rafaelmartins/julialabs-pcb-challenge2025/README.md

# julialabs-pcb-challenge2025

Meu projeto do Julialabs PCB Challenge 2025.

Placa de circuito impresso baseada no formato de um cartão de visitas tradicional, implementando um sintetizador digital polifônico completo, com mini teclado e alto falante embutidos e saída de audio em linha para gravações.

> [!NOTE]
> **Recursos Externos**
>
> - [Apresentação](https://rafaelmartins.com/s/julialabs-pcb-challenge-2025/)
> - [Lista de Componentes na Mouser](https://www.mouser.de/api/CrossDomain/GetContext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)

## Revisão `20250818`

- [Lista Interativa de Materiais](https://rafaelmartins.github.io/julialabs-pcb-challenge2025/business-card-synth.html)
- [Diagrama Esquemático](https://rafaelmartins.github.io/julialabs-pcb-challenge2025/business-card-synth.pdf)
- [Arquivos Gerber](https://github.com/rafaelmartins/julialabs-pcb-challenge2025/blob/main/pcb/gerber/business-card-synth_rev20250818.zip)

Renderização 3D

## Licença

O projeto de hardware esta disponível a partir de uma [Licença CERN-OHL-S-2.0](LICENSE).
