rafaelmartins/julialabs-pcb-challenge2025/pcb/business-card-synth.kicad_pcb

## KiCad design pcb/business-card-synth.kicad_pcb (2025-08-19)

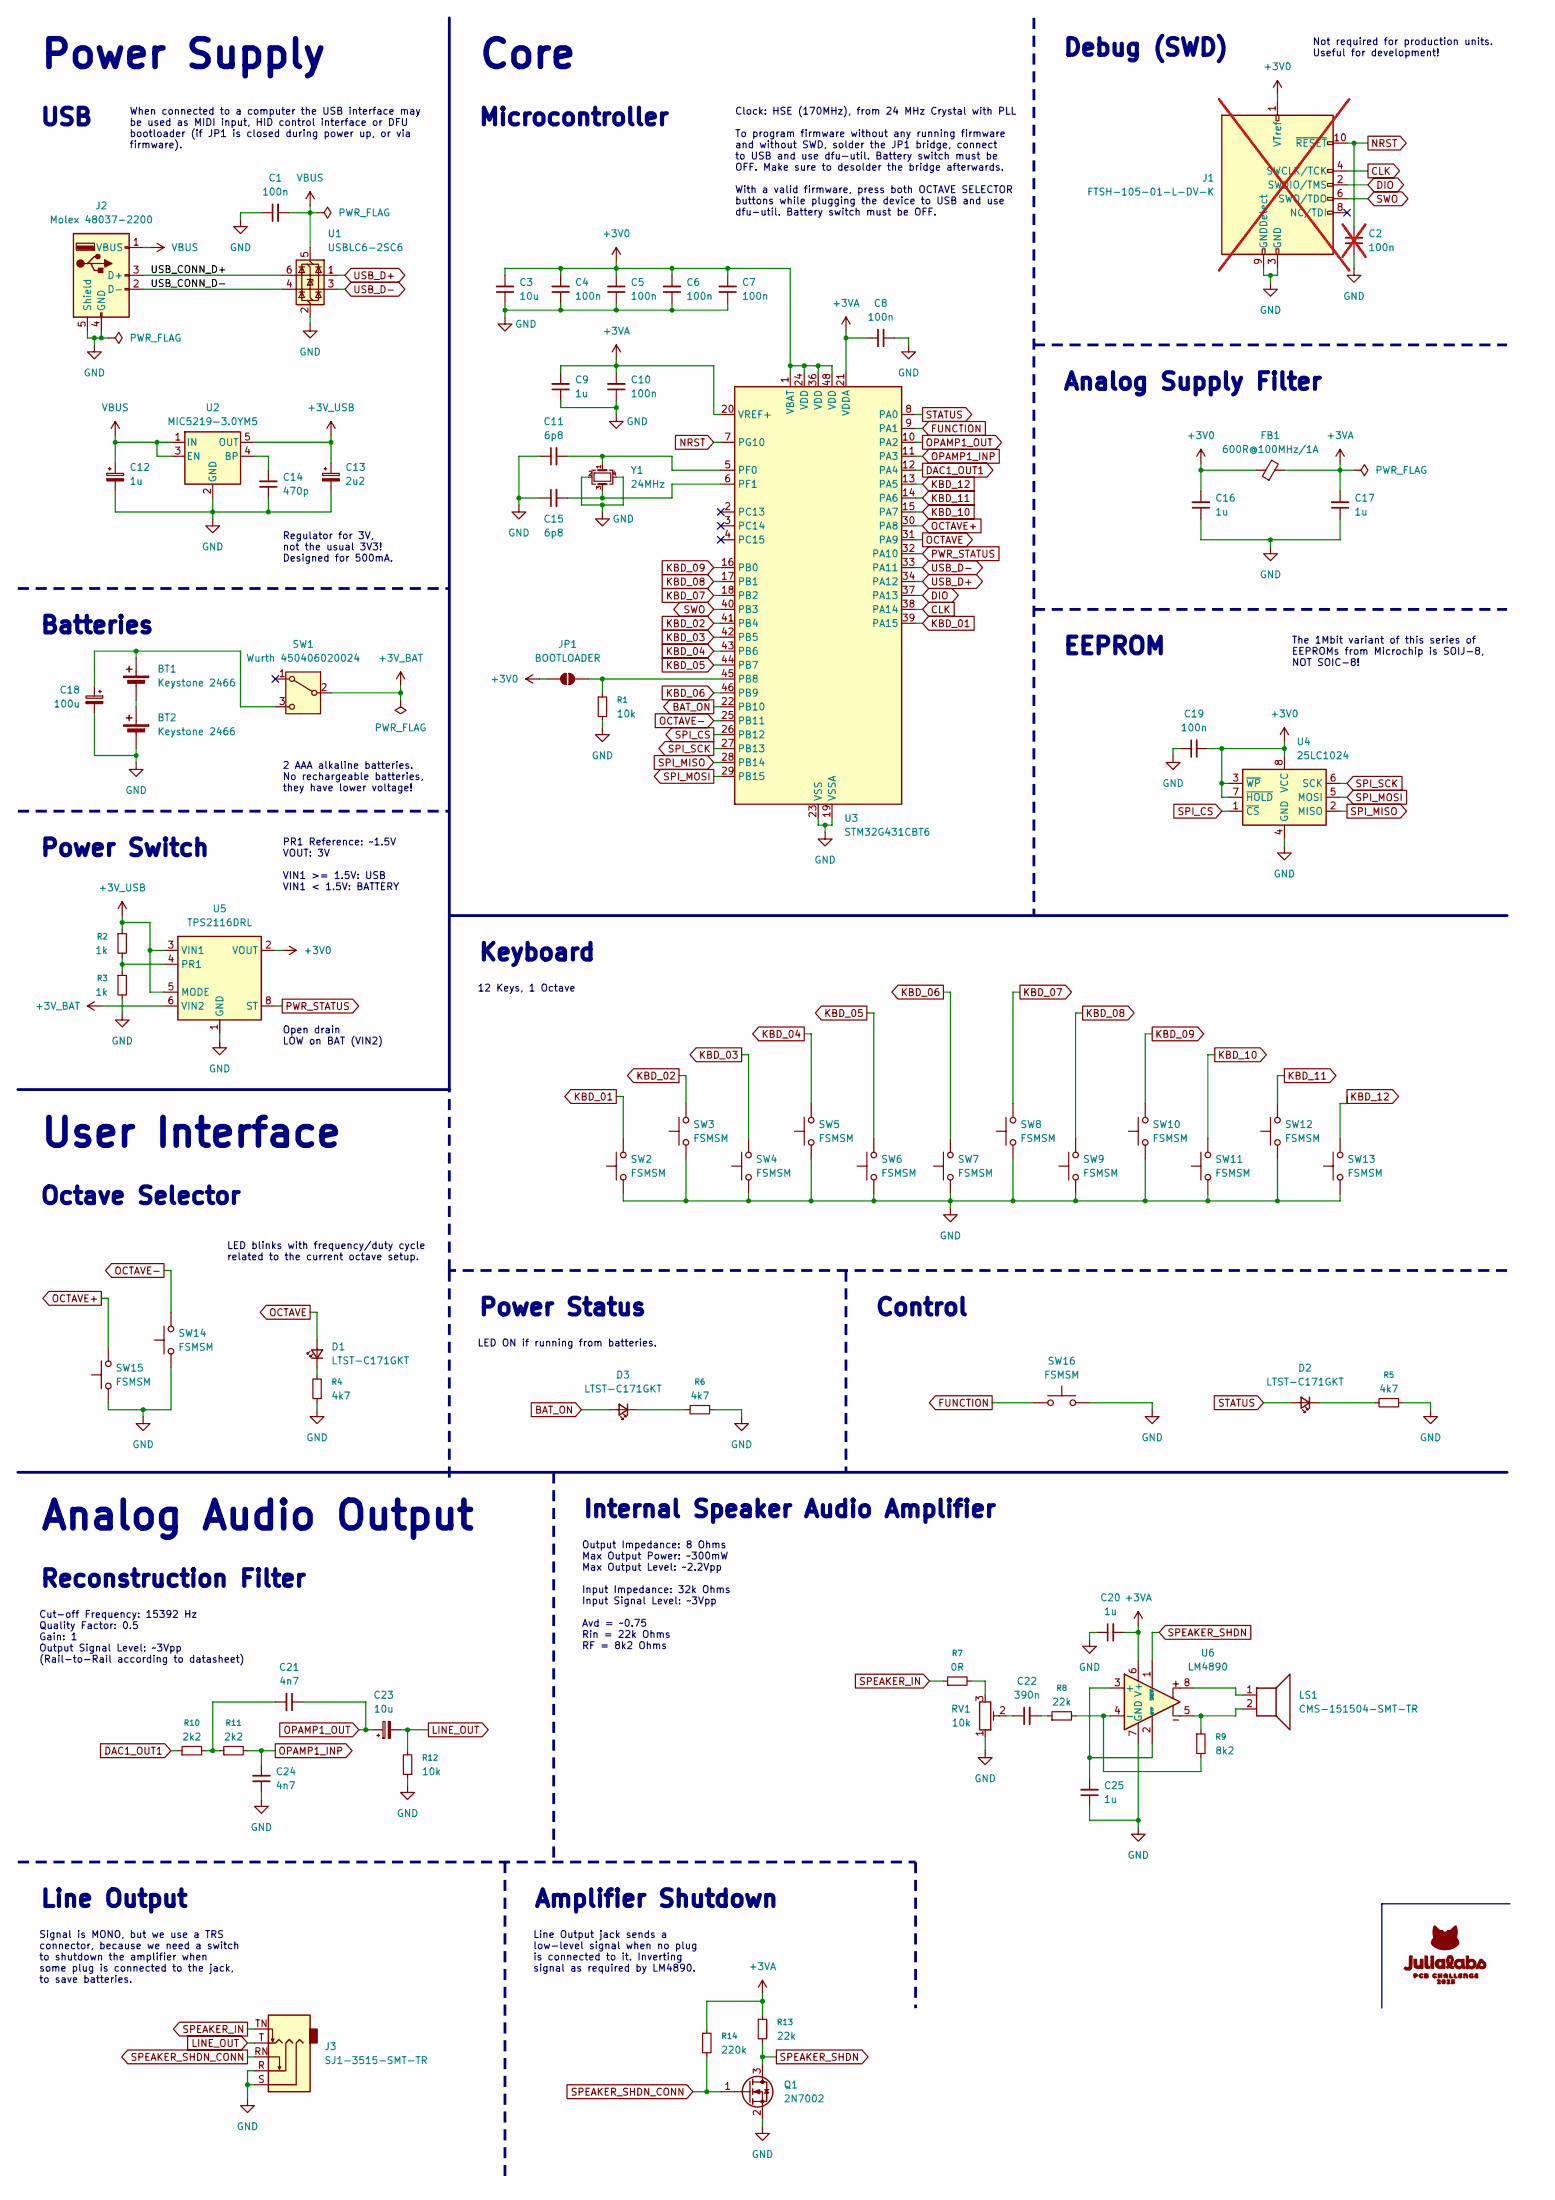
[picture p1: schematic business-card-synth.kicad_sch]

Parts:
BT1, BT2: Keystone 2466; BatteryHolder_Keystone_2466_1xAAA; Mouser No. 534-2466
C1, C4, C5, C6, C7, C8, C10, C19: 100n; C_0805_2012Metric; Mouser No. 603-CC805KRX7R9BB104
C2: 100n; C_0805_2012Metric; Mouser No. 603-CC805KRX7R9BB104; not fitted
C3: 10u; C_0805_2012Metric; Mouser No. 603-CC805KKX7R6BB106
C9, C16, C17, C20, C25: 1u; C_0805_2012Metric; Mouser No. 603-CC805KKX7R7BB105
C11, C15: 6p8; C_0603_1608Metric; Mouser No. 603-CC603CRNPO9BN6R8
C12: 1u; CP_EIA-3216-18_Kemet-A; Mouser No. 80-T491A105K25AT7280
C13: 2u2; CP_EIA-3216-18_Kemet-A; Mouser No. 80-T491A225K25AT7280
C14: 470p; C_0603_1608Metric; Mouser No. 603-C0603JRNPO9BN471
C18: 100u; CP_Elec_6.3x5.8; Mouser No. 710-875105344010
C21, C24: 4n7; C_1206_3216Metric; Mouser No. 667-ECH-U1H472JX5
C22: 390n; C_0805_2012Metric; Mouser No. 603-CC805KKX7R7BB394
C23: 10u; CP_Elec_6.3x5.8; Mouser No. 710-875105544001
D1, D2, D3: LTST-C171GKT; LED_0805_2012Metric_Pad1.15x1.40mm_HandSolder; Mouser No. 859-LTST-C171GKT
FB1: 600R@100MHz/1A; L_0805_2012Metric; Mouser No. 660-CZP2AFTTD601P
J1: FTSH-105-01-L-DV-K; Connector_Samtec_FTSH-105-01-L-DV-K; Mouser No. 200-FTSH10501LDVK; not fitted
J2: Molex 48037-2200; USB_A_Molex_48037-2200_Horizontal; Mouser No. 538-48037-2200
J3: SJ1-3515-SMT-TR; Jack_3.5mm_SameSky_SJ1-3515-SMT_Horizontal; Mouser No. 490-SJ1-3515-SMT-TR
JP1: BOOTLOADER; SolderJumper-2_P1.3mm_Open_TrianglePad1.0x1.5mm
LS1: CMS-151504-SMT-TR; Speaker_SameSky_CMS-151504-SMT-TR; Mouser No. 179-CMS-151504-SMTTR
Q1: 2N7002; SOT-23; Mouser No. 610-2N7002
R1, R12: 10k; R_0805_2012Metric; Mouser No. 603-AC0805FR-0710KL
R2, R3: 1k; R_0805_2012Metric; Mouser No. 603-AC0805FR-071KL
R4, R5, R6: 4k7; R_0805_2012Metric; Mouser No. 603-AC0805FR-074K7L
R7: 0R; R_0805_2012Metric; Mouser No. 603-AC0805FR-070RL
R8, R13: 22k; R_0805_2012Metric; Mouser No. 603-AC0805FR-0722KL
R9: 8k2; R_0805_2012Metric; Mouser No. 603-AC0805FR-078K2L
R10, R11: 2k2; R_0805_2012Metric; Mouser No. 603-AC0805FR-072K2L
R14: 220k; R_0805_2012Metric; Mouser No. 603-AC0805FR-07220KL
RV1: 10k; Potentiometer_Bourns_3306F_Horizontal; Mouser No. 652-3306F-1-103
SW1: Wurth 450406020024; SW_SPDT_Wurth_450406020024; Mouser No. 710-450406020024
SW2, SW3, SW4, SW5, SW6, SW7, SW8, SW9, SW10, SW11, SW12, SW13, SW14, SW15, SW16: FSMSM; SW_SPST_FSMSM; Mouser No. 506-FSMSM
U1: USBLC6-2SC6; SOT-23-6; Mouser No. 511-USBLC6-2SC6
U2: MIC5219-3.0YM5; SOT-23-5; Mouser No. 998-MIC5219-3.0YM5TR
U3: STM32G431CBT6; LQFP-48_7x7mm_P0.5mm; Mouser No. 511-STM32G431CBT6
U4: 25LC1024; SOIC-8_5.3x5.3mm_P1.27mm; Mouser No. 579-25LC1024-E/SM
U5: TPS2116DRL; SOT-583-8; Mouser No. 595-TPS2116DRLR
U6: LM4890; SOIC-8_3.9x4.9mm_P1.27mm; Mouser No. 926-LM4890MX/NOPB
Y1: 24MHz; Crystal_SMD_2016-4Pin_2.0x1.6mm; Mouser No. 344-CS10820-24M

Connections:
+3V0: C3.2, C4.2, C5.2, C6.2, C7.2, C16.2, C19.2, FB1.1, J1.1 (VTref), JP1.1 (A), U3.1 (VBAT), U3.24 (VDD), U3.36 (VDD), U3.48 (VDD), U4.3 (~WP), U4.7 (~HOLD), U4.8 (VCC), U5.2 (VOUT), U5.7 (VOUT)
+3VA: C8.2, C9.2, C10.2, C17.2, C20.2, FB1.2, R13.1, R14.1, U3.20 (VREF+), U3.21 (VDDA), U6.6 (V+)
+3V_BAT: SW1.2 (B), U5.6 (VIN2)
+3V_USB: C13.1, R2.1, U2.5 (OUT), U5.3 (VIN1), U5.5 (MODE)
/USB_CONN_D+: J2.3 (D+), U1.6 (I/O1)
/USB_CONN_D-: J2.2 (D-), U1.4 (I/O2)
BAT_ON: D3.2 (A), U3.22 (PB10)
CLK: J1.4 (SWCLK/TCK), U3.38 (PA14)
DAC1_OUT1: R10.1, U3.12 (PA4)
DIO: J1.2 (SWDIO/TMS), U3.37 (PA13)
FUNCTION: SW16.2, U3.9 (PA1)
GND: BT2.2 (-), C1.1, C2.1, C3.1, C4.1, C5.1, C6.1, C7.1, C8.1, C9.1, C10.1, C11.1, C12.2, C13.2, C14.1, C15.1, C16.1, C17.1, C18.2, C19.1, C20.1, C24.1, C25.1, J1.3 (GND), J1.5 (GND), J1.9 (GNDDetect), J2.4 (GND), J2.5 (Shield), J3.R, J3.S, Q1.2 (S), R1.2, R3.2, R4.1, R5.1, R6.1, R12.1, RV1.1, SW2.1, SW3.1, SW4.1, SW5.1, SW6.1, SW7.1, SW8.1, SW9.1, SW10.1, SW11.1, SW12.1, SW13.1, SW14.1, SW15.1, SW16.1, U1.2 (GND), U2.2 (GND), U3.19 (VSSA), U3.23 (VSS), U3.35 (VSS), U3.47 (VSS), U4.4 (GND), U5.1 (GND), U6.7 (GND), Y1.2, Y1.4
KBD_01: SW2.2, U3.39 (PA15)
KBD_02: SW3.2, U3.41 (PB4)
KBD_03: SW4.2, U3.42 (PB5)
KBD_04: SW5.2, U3.43 (PB6)
KBD_05: SW6.2, U3.44 (PB7)
KBD_06: SW7.2, U3.46 (PB9)
KBD_07: SW8.2, U3.18 (PB2)
KBD_08: SW9.2, U3.17 (PB1)
KBD_09: SW10.2, U3.16 (PB0)
KBD_10: SW11.2, U3.15 (PA7)
KBD_11: SW12.2, U3.14 (PA6)
KBD_12: SW13.2, U3.13 (PA5)
LINE_OUT: C23.2, J3.T, R12.2
NRST: C2.2, J1.10 (~RESET), U3.7 (PG10)
unnamed: BT1.1 (+), C18.1, SW1.3 (C)
unnamed: BT1.2 (-), BT2.1 (+)
unnamed: C21.2, R10.2, R11.1
unnamed: C22.1, RV1.2
unnamed: C22.2, R8.1
unnamed: D1.1 (K), R4.2
unnamed: D2.1 (K), R5.2
unnamed: D3.1 (K), R6.2
unnamed: JP1.2 (B), R1.1, U3.45 (PB8)
unnamed: LS1.1, U6.8
unnamed: LS1.2, R9.1, U6.5
unnamed: R7.2, RV1.3
unnamed: C14.2, U2.4 (BP)
unnamed: C11.2, U3.5 (PF0), Y1.1
unnamed: C15.2, U3.6 (PF1), Y1.3
unnamed: R2.2, R3.1, U5.4 (PR1)
unnamed: C25.2, U6.2 (BYP), U6.3 (+)
unnamed: R8.2, R9.2, U6.4 (-)
OCTAVE: D1.2 (A), U3.31 (PA9)
OCTAVE+: SW15.2, U3.30 (PA8)
OCTAVE-: SW14.2, U3.25 (PB11)
OPAMP1_INP: C24.2, R11.2, U3.11 (PA3)
OPAMP1_OUT: C21.1, C23.1, U3.10 (PA2)
PWR_STATUS: U3.32 (PA10), U5.8 (ST)
SPEAKER_IN: J3.TN, R7.1
SPEAKER_SHDN: Q1.3 (D), R13.2, U6.1 (~SHDN)
SPEAKER_SHDN_CONN: J3.RN, Q1.1 (G), R14.2
SPI_CS: U3.26 (PB12), U4.1 (~CS)
SPI_MISO: U3.28 (PB14), U4.2 (MISO)
SPI_MOSI: U3.29 (PB15), U4.5 (MOSI)
SPI_SCK: U3.27 (PB13), U4.6 (SCK)
STATUS: D2.2 (A), U3.8 (PA0)
SWO: J1.6 (SWO/TDO), U3.40 (PB3)
USB_D+: U1.1 (I/O1), U3.34 (PA12)
USB_D-: U1.3 (I/O2), U3.33 (PA11)
VBUS: C1.2, C12.1, J2.1 (VBUS), U1.5 (VBUS), U2.1 (IN), U2.3 (EN)

Notes on the sheet:
Clock: HSE (170MHz), from 24 MHz Crystal with PLL To program firmware without any running firmware and without SWD, solder the JP1 bridge, connect to USB and use dfu-util. Battery switch must be OFF. Make sure to desolder the bridge afterwards. With a valid firmware, press both OCTAVE SELECTOR butt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
Power Status
Internal Speaker Audio Amplifier
Line Output
2 AAA alkaline batteries. No rechargeable batteries, they have lower voltage!
Line Output jack sends a low-level signal when no plug is connected to it. Inverting signal as required by LM4890.
Open drain LOW on BAT (VIN2)
Control
Regulator for 3V, not the usual 3V3! Designed for 500mA.
Analog Audio Output
USB
Signal is MONO, but we use a TRS connector, because we need a switch to shutdown the amplifier when some plug is connected to the jack, to save batteries.
12 Keys, 1 Octave
PR1 Reference: ~1.5V VOUT: 3V VIN1 >= 1.5V: USB VIN1 < 1.5V: BATTERY
Microcontroller
Analog Supply Filter
When connected to a computer the USB interface may be used as MIDI input, HID control interface or DFU bootloader (if JP1 is closed during power up, or via firmware).
LED ON if running from batteries.
Keyboard
The 1Mbit variant of this series of EEPROMs from Microchip is SOIJ-8, NOT SOIC-8!
Debug (SWD)
Power Supply
EEPROM
Batteries
Octave Selector
Cut-off Frequency: 15392 Hz Quality Factor: 0.5 Gain: 1 Output Signal Level: ~3Vpp (Rail-to-Rail according to datasheet)
User Interface
Power Switch
Output Impedance: 8 Ohms Max Output Power: ~300mW Max Output Level: ~2.2Vpp Input Impedance: 32k Ohms Input Signal Level: ~3Vpp Avd = ~0.75 Rin = 22k Ohms RF = 8k2 Ohms
Not required for production units. Useful for development!
Core
Amplifier Shutdown
Reconstruction Filter
LED blinks with frequency/duty cycle related to the current octave setup.

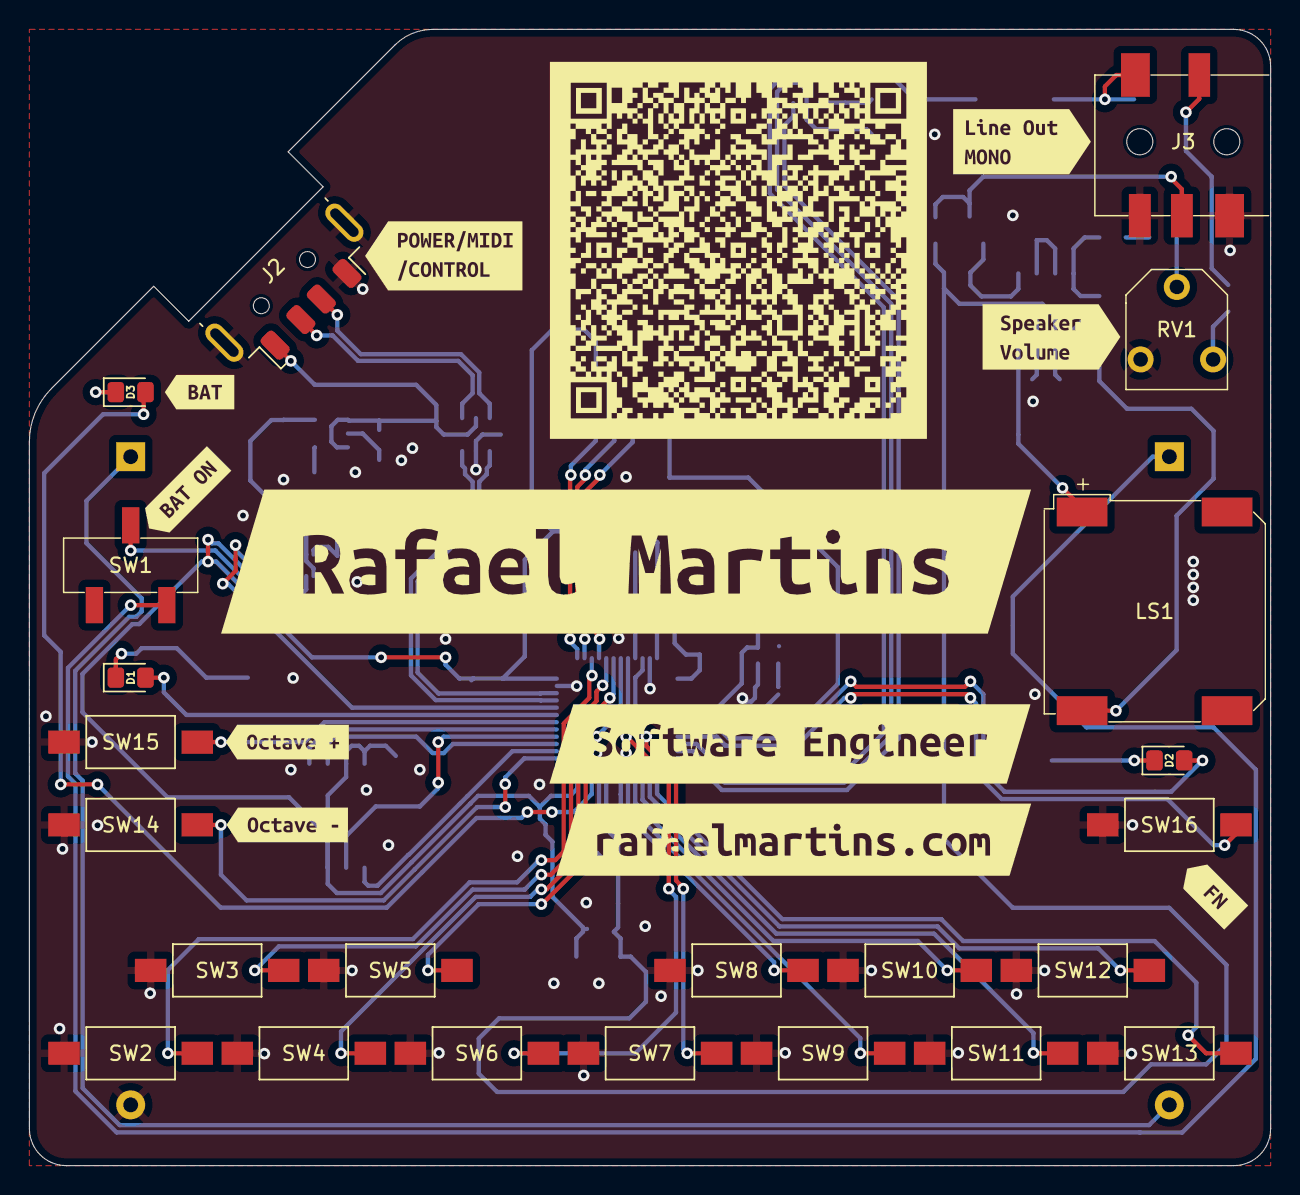
[picture p2: board business-card-synth.kicad_pcb from above]

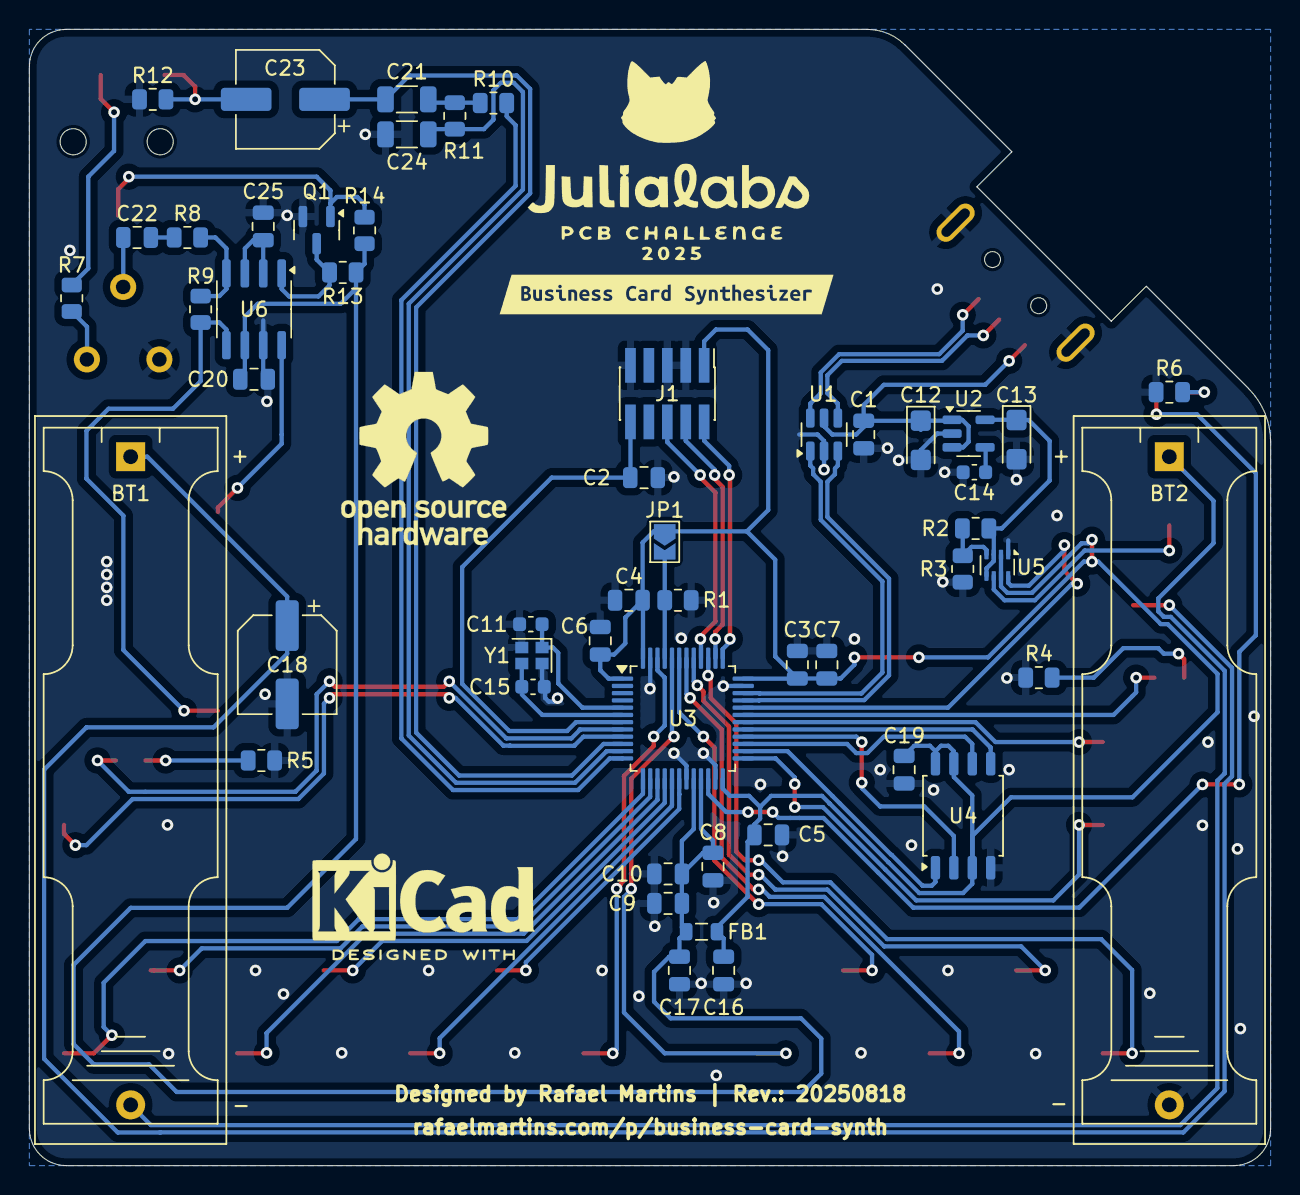
[picture p3: board business-card-synth.kicad_pcb from below]

Board: 2 copper layers, 85.6 x 78.4 mm, 87 parts (53 on the bottom side), 62 nets.

Other parts of the board:
kibuzzard-68A13B7B: G***; kibuzzard-68A13B7B
kibuzzard-68A26CA8: G***; kibuzzard-68A26CA8
kibuzzard-68A26E1C: G***; kibuzzard-68A26E1C
kibuzzard-68A29CF7: G***; kibuzzard-68A29CF7
kibuzzard-68A2383A: G***; kibuzzard-68A2383A
kibuzzard-68A23822: G***; kibuzzard-68A23822
kibuzzard-687D9D5C: G***; kibuzzard-687D9D5C
kibuzzard-687D97D9: G***; kibuzzard-687D97D9
kibuzzard-687D98B0: G***; kibuzzard-687D98B0
kibuzzard-687DA195: G***; kibuzzard-687DA195
kibuzzard-687EEB56: G***; kibuzzard-687EEB56
kibuzzard-687FF431: G***; kibuzzard-687FF431
