rafaelmartins/julialabs-pcb-challenge2025/(commit log)

2025-08-19 Commit inicial
    [business-card-synth.kicad_pcb, business-card-synth.kicad_sch]
2025-08-19 tentando renderizar a pcb com solder mask preta
2025-08-19 usar preset novo no kicad-cli
