rafaelmartins/julialabs-pcb-challenge2025/(notices)

Notices in the files:
pcb/business-card-synth.kicad_pcb:
Released under CERN Open Hardware Licence Version 2 - Strongly Reciprocal
